Healone/Station_meteo/Rapports séances/GregoryTonner.md

Rapport de projet semaine 1  => 27/08/2021

- Découverte du projet et création du GitHub.
- Prise de connaissance du travail effectué les années précédentes.
- Prise de connaissance du travail à faire pour la mise en oeuvre du projet.
- Réunion d'information avec le client dans le but de créer un cahier des charges.

Rapport de projet semaine 2 => 09/09/2021

- Etude de la documentation technique.
- Découverte du schéma Eagle de la carte électronique.
- Installation du connecteur RJ45 femelle dans le logiciel Eagle (10%).
- Appréhension des besoins du client pour le cahier des charges.

Rapport de projet semaine 3 => 17/09/2021

- Etude du PCB sur Eagle
- Modification du PCB et routage.

Rapport de projet semaine 4 => 23/09/2021

- Recherche sur le module GSM et sur sont utilisation pour faire des requetes PHP.
  
Rapport de projet semaine 5 => 1/10/2021

- Brasage des composant CMS, sur la face avant avec le four. 
- Brasage à la main des composants CMS sur la face arrière du PCB.
