Healone/Station_meteo/ESP_LoRa_Internal/definition.h

/**************************************/
//  Variable Lora                     //
/**************************************/

//define the pins used by the LoRa transceiver module
#define SCK 18
#define MISO 19
#define MOSI 23

#define SS 5
#define RST 14
#define DI0 26

/**************************************/
//  Variable Fonction                 //
/**************************************/

//Viable defini
#define MEASURE 13


//Taille payload
#define PAYLOAD_LEN 13
