Healone/Station_meteo/(commit log)

2022-03-05 Rename Doc/quentin gaglio to Rapport de repise de projet
2022-03-06 rapport de séance quentin
